jzimme14/Ares/Ares_v1/IchBinEineBiene1.jpg

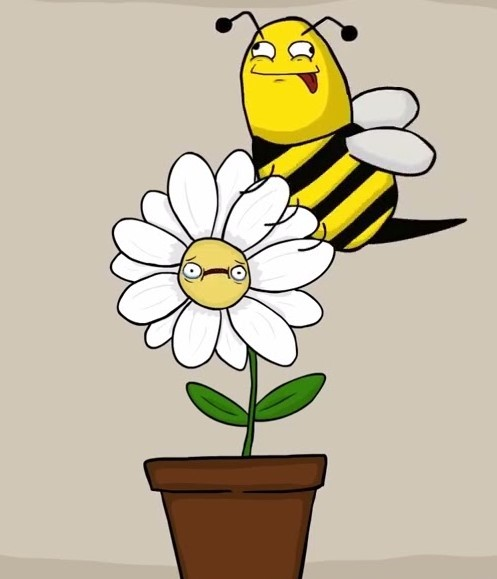
Ares_v1/IchBinEineBiene1.jpg
