jzimme14/Ares/README.md

# Ares
Flight Controller for autonomous drone.
