jzimme14/Ares/Ares_v1/arduino-nano-33-iot-pinout.png

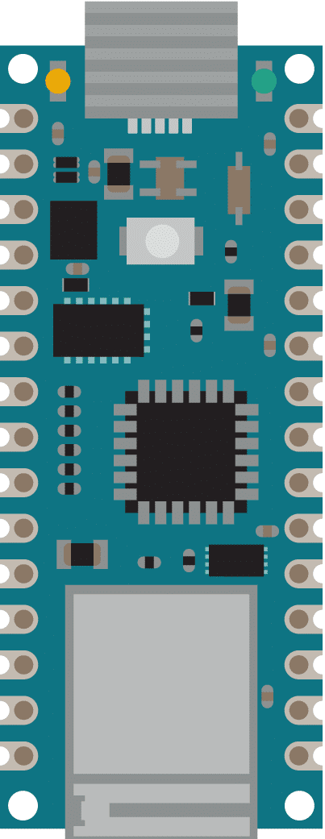
Ares_v1/arduino-nano-33-iot-pinout.png
