jzimme14/Ares/Ares_v1/retardedBee.png

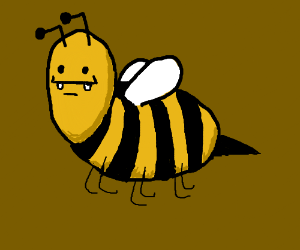
Ares_v1/retardedBee.png
