jzimme14/Ares/Ares_FC/parts/STM32F405RGT6/3D/STM32F405RGT6.stp

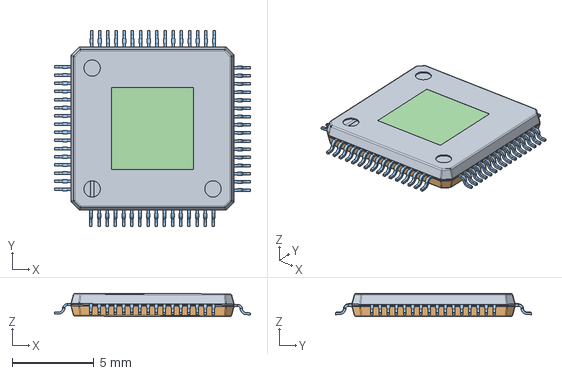
[picture p4: CAD file, 2024-05-15]
Ares_FC/parts/STM32F405RGT6/3D/STM32F405RGT6.stp
12.0 x 12.0 x 1.43 mm
