jzimme14/Ares/Ares_v1/parts/XT60-M.step

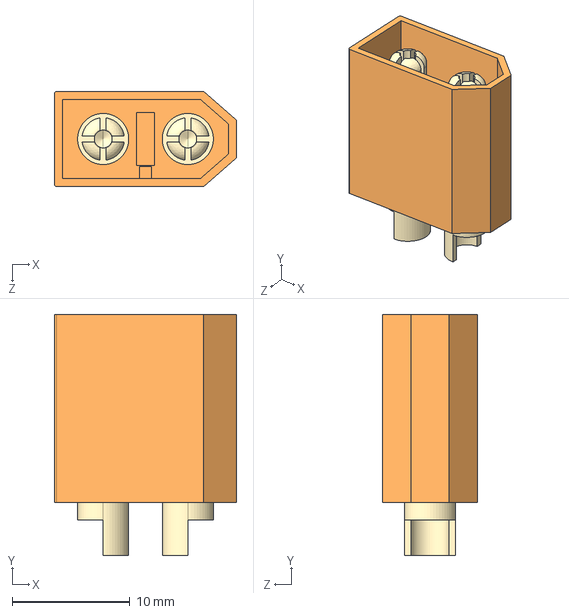
[picture p5: CAD file, 2025-03-02]
Ares_v1/parts/XT60-M.step
15.5 x 20.5 x 8.10 mm
