jzimme14/Ares/parts/1N4728A/3D/1N4728A.stp

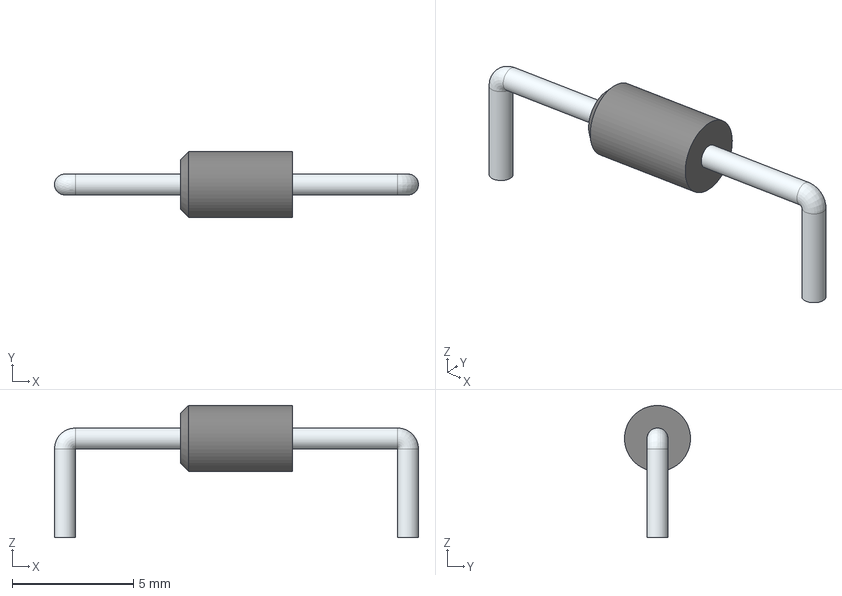
[picture p6: CAD file, 2025-03-02]
parts/1N4728A/3D/1N4728A.stp
15.0 x 2.72 x 5.44 mm
