jzimme14/Ares/parts/INA240A3EDRQ1/3D/INA240A3EDRQ1.stp

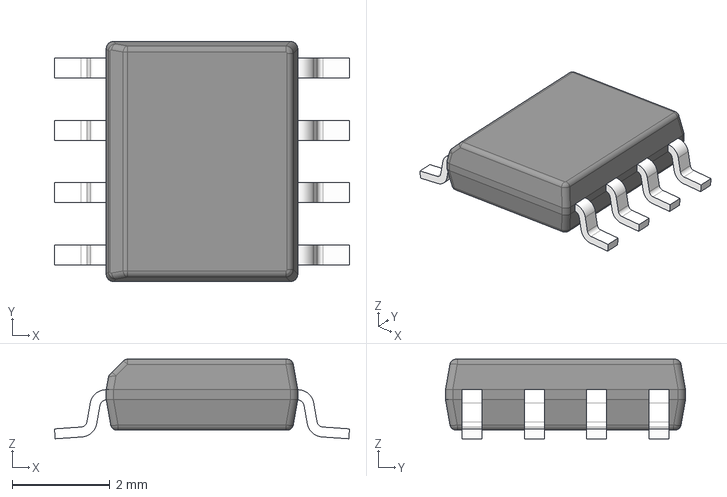
[picture p7: CAD file, 2025-03-02]
parts/INA240A3EDRQ1/3D/INA240A3EDRQ1.stp
6.02 x 4.90 x 1.63 mm
BODY-SO
LEAD-D0008A x 8
