jzimme14/Ares/parts/IR2101PBF/3D/IR2101PBF.stp

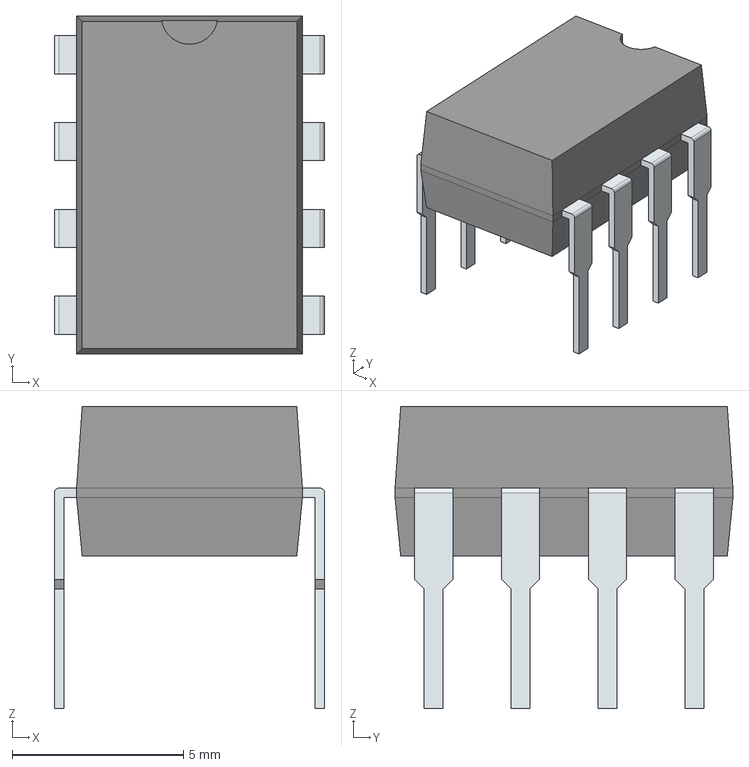
[picture p8: CAD file, 2025-03-02]
parts/IR2101PBF/3D/IR2101PBF.stp
7.90 x 9.88 x 8.83 mm
PinsArrayLR
