jzimme14/Ares/parts/IRLZ44NPBF/3D/IRLZ44NPBF.stp

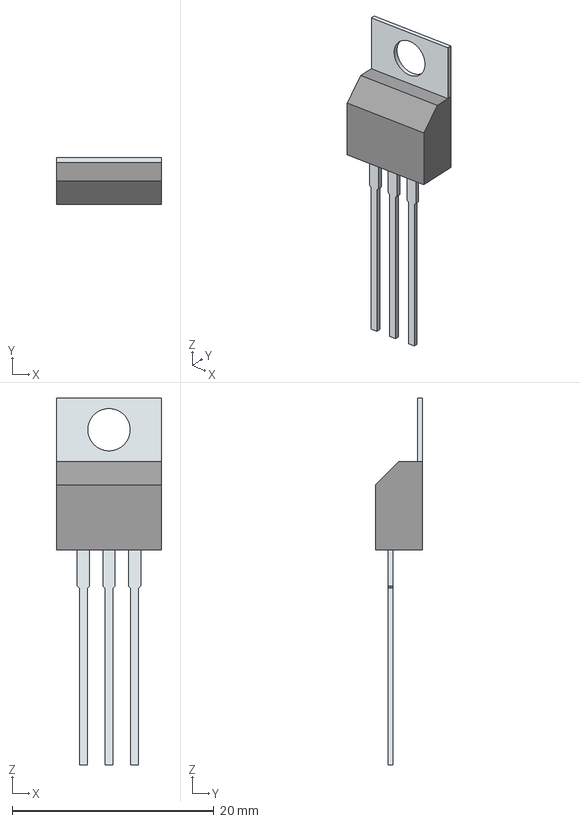
[picture p9: CAD file, 2025-03-02]
parts/IRLZ44NPBF/3D/IRLZ44NPBF.stp
10.4 x 4.69 x 36.4 mm
Tab
PinsArray
