jzimme14/Ares/parts/STM32F411RET6/STM32F411RET6/3D/STM32F411RET6.stp

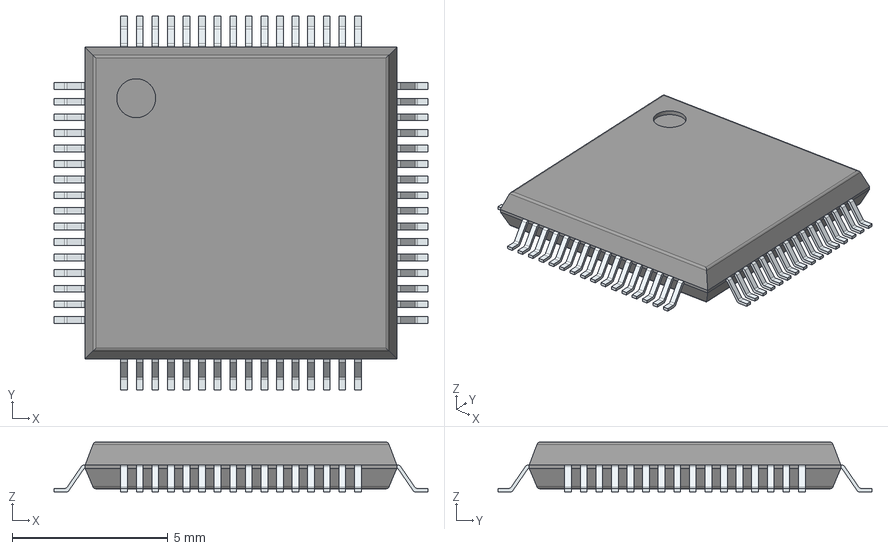
[picture p10: CAD file, 2025-03-02]
parts/STM32F411RET6/STM32F411RET6/3D/STM32F411RET6.stp
12.0 x 12.0 x 1.60 mm
PinsArrayLR
PinsArrayTB
