jzimme14/Ares/parts/STTH4L06/3D/STTH4L06.stp

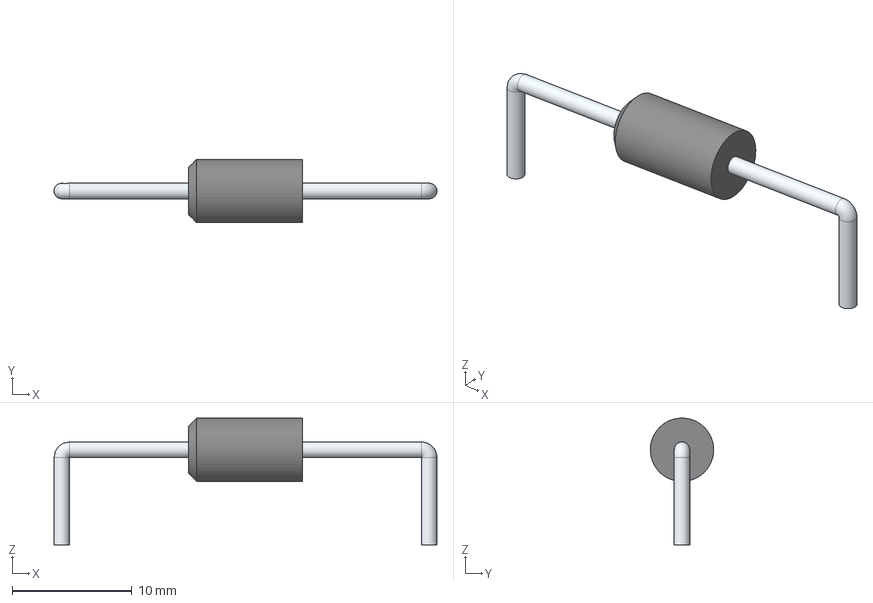
[picture p11: CAD file, 2025-03-02]
parts/STTH4L06/3D/STTH4L06.stp
32.0 x 5.30 x 10.6 mm
