jzimme14/Ares/Ares_v1/parts/B4B-XH-AM__LF__SN_.step

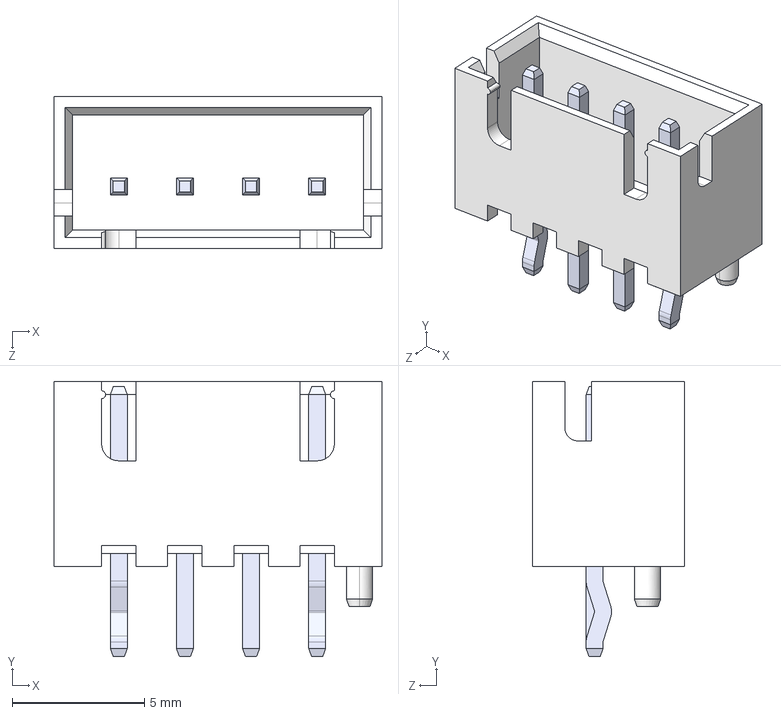
[picture p12: CAD file, 2025-03-02]
Ares_v1/parts/B4B-XH-AM__LF__SN_.step
12.4 x 10.4 x 5.75 mm
