jzimme14/Ares/Ares_v1/parts/M20-7821642/3D/M20-7821642.stp

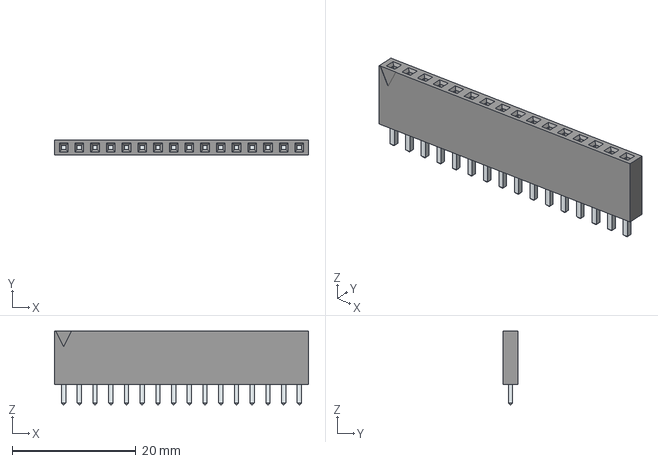
[picture p13: CAD file, 2025-03-02]
Ares_v1/parts/M20-7821642/3D/M20-7821642.stp
41.0 x 2.50 x 11.9 mm
LeadsArray
