jzimme14/Ares/parts/Wuerth_Quartz_25MHz/3D/830107871909.stp

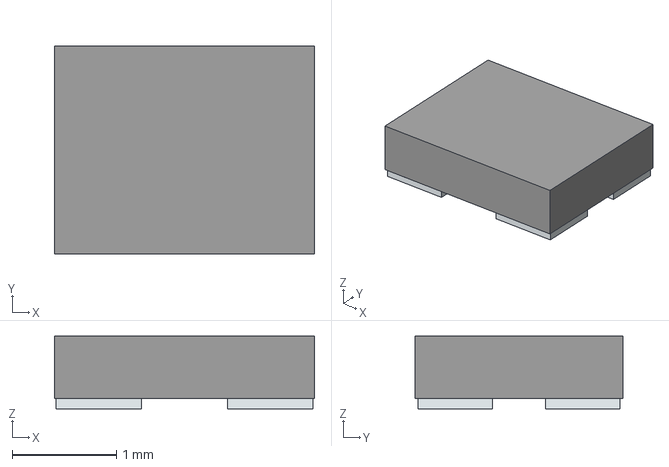
[picture p14: CAD file, 2025-03-02]
parts/Wuerth_Quartz_25MHz/3D/830107871909.stp
2.50 x 2.00 x 0.7 mm
Pins
