jzimme14/Ares/(list of files, cad)

Other CAD files:
Ares_FC/parts/MICRO-SD-CARD/Allegro/microsdcard.psm
Ares_FC/parts/MICRO-SD-CARD/DEHDL/micro_sd_card/chips/chips.prt
Ares_FC/parts/STM32F405RGT6/Allegro/qfp50p1200x1200x160-64n.psm
Ares_FC/parts/STM32F405RGT6/DEHDL/stm32f405rgt6/chips/chips.prt
Ares_FC/parts/STM32F405VGT6/Allegro/qfp50p1600x1600x160-100n.psm
Ares_FC/parts/STM32F405VGT6/DEHDL/stm32f405vgt6/chips/chips.prt
Ares_FC/parts/STM32H742VIT6/Allegro/qfp50p1600x1600x160-100n.psm
Ares_FC/parts/STM32H742VIT6/DEHDL/stm32h742vit6/chips/chips.prt
Ares_v1/parts/M20-7821642/Allegro/rhdr16w70p0x254_1x16_4104x250x865p.psm
Ares_v1/parts/M20-7821642/DEHDL/m20_7821642/chips/chips.prt
parts/1N4728A/Allegro/dioad1413w86l463d238.psm
parts/1N4728A/DEHDL/1n4728a/chips/chips.prt
parts/INA240A3EDRQ1/Allegro/soic127p600x175-8n.psm
parts/INA240A3EDRQ1/DEHDL/ina240a3edrq1/chips/chips.prt
parts/IR2101PBF/Allegro/dip762w56p254l988h533q8n.psm
parts/IR2101PBF/DEHDL/ir2101pbf/chips/chips.prt
parts/IRLZ44NPBF/Allegro/to254p469x1042x1967-3p.psm
parts/IRLZ44NPBF/DEHDL/irlz44npbf/chips/chips.prt
parts/STM32F411RET6/STM32F411RET6/Allegro/qfp50p1200x1200x160-64n.psm
parts/STM32F411RET6/STM32F411RET6/DEHDL/stm32f411ret6/chips/chips.prt
parts/STTH4L06/Allegro/dioad3070w130l950d530.psm
parts/STTH4L06/DEHDL/stth4l06/chips/chips.prt
parts/Wuerth_Quartz_25MHz/Allegro/830107871909.psm
parts/Wuerth_Quartz_25MHz/DEHDL/830107871909/chips/chips.prt
