jzimme14/Ares/(list of files, drawings)

Other design files:
Ares_v1/parts/M20-7821642/Altium/M20-7821642.SchLib
Ares_v1/parts/M20-7821642/Altium/RHDR16W70P0X254_1X16_4104X250X865P.PcbLib
parts/1N4728A/Altium/1N4728A.SchLib
parts/1N4728A/Altium/DIOAD1413W86L463D238.PcbLib
parts/INA240A3EDRQ1/Altium/INA240A3EDRQ1.SchLib
parts/INA240A3EDRQ1/Altium/SOIC127P600X175-8N.PcbLib
parts/IR2101PBF/Altium/DIP762W56P254L988H533Q8N.PcbLib
parts/IR2101PBF/Altium/IR2101PBF.SchLib
parts/IRLZ44NPBF/Altium/IRLZ44NPBF.SchLib
parts/IRLZ44NPBF/Altium/TO254P469X1042X1967-3P.PcbLib
parts/STM32F411RET6/STM32F411RET6/Altium/QFP50P1200X1200X160-64N.PcbLib
parts/STM32F411RET6/STM32F411RET6/Altium/STM32F411RET6.SchLib
parts/STTH4L06/Altium/DIOAD3070W130L950D530.PcbLib
parts/STTH4L06/Altium/STTH4L06.SchLib
parts/Wuerth_Quartz_25MHz/Altium/830107871909.PcbLib
parts/Wuerth_Quartz_25MHz/Altium/830107871909.SchLib
