jzimme14/Ares/Beestaeuber_v1/Beestaeuber_v1_project/Beestaeuber_v1_project.kicad_pcb

## KiCad design Beestaeuber_v1/Beestaeuber_v1_project/Beestaeuber_v1_project.kicad_pcb (2025-03-02)

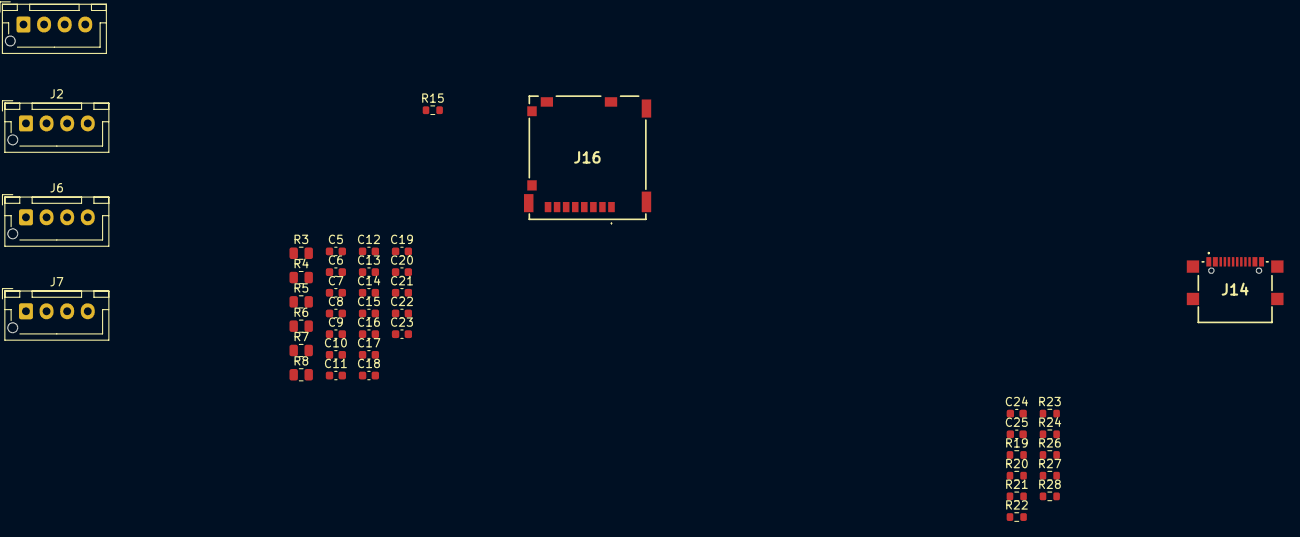
[picture p15: board Beestaeuber_v1_project.kicad_pcb from above]

Board: 2 copper layers, 43 parts (0 on the bottom side), 20 nets, no tracks yet.

Parts:
C5, C6, C7, C8, C10, C11, C12, C13, C14, C15, C20, C21, C24: 100n; C_0603_1608Metric
C9, C25: 10u; C_0603_1608Metric
C16, C18: 10n; C_0603_1608Metric
C17, C19: 1u; C_0603_1608Metric
C22, C23: 2u2; C_0603_1608Metric
J1: B4B-XH-AM__LF__SN_; JST_XH_B4B-XH-AM_1x04_P2.50mm_Vertical
J2: ELRS_Receiver; JST_XH_B4B-XH-AM_1x04_P2.50mm_Vertical
J6: CAM Connector; JST_XH_B4B-XH-AM_1x04_P2.50mm_Vertical
J7: VTX Output; JST_XH_B4B-XH-AM_1x04_P2.50mm_Vertical
J14: GSB1C41110SSHR
J16: MEM2090-00-145-00-A; MEM20900014500A
R3: 47k; R_0805_2012Metric
R4, R6, R8: 330k; R_0805_2012Metric
R5: 33k; R_0805_2012Metric
R7: 22k; R_0805_2012Metric
R15, R19, R20, R21, R22, R23, R24: 47k; R_0603_1608Metric
R26, R27: 10k; R_0603_1608Metric
R28: 100k; R_0603_1608Metric

Connections:
+3.3VA: C16.1, C17.1, C18.1, C19.1
+3V3: C9.1, C10.1, C11.1, C12.1, C13.1, C14.1, C15.1, C25.1, J16.4 (VDD), R15.1, R19.1, R20.1, R21.1, R22.1, R23.1, R24.1, R26.1, R27.1
+5V: C8.1, J2.3
/D14/A0: C7.1, R7.2, R8.1
/D15/A1: C6.1, R5.2, R6.1
/D20/A6: C5.1, R3.2, R4.1
/Lipo_Cell_1: J1.2, R7.1
/Lipo_Cell_1_2: J1.3, R5.1
/Lipo_Cell_1_2_3: J1.4, R3.1
GND: C5.2, C6.2, C7.2, J1.1, J16.6 (VSS), J16.10 (GROUND_1), J16.11 (GROUND_2), J16.12 (GROUND_3), J16.13 (GROUND_4), J16.14 (GROUND_5), J16.15 (GROUND_6), R4.2, R6.2, R8.2
SDMMC1_CMD: J16.3 (CMD), R24.2
SDMMC1_D0: J16.7 (DAT0), R20.2
SDMMC1_D1: J16.8 (DAT1), R15.2, R19.2
SDMMC1_D2: J16.1 (DAT2), R22.2
SDMMC1_D3: J16.2 (CD/DAT3), R23.2
USB_DN_1: J14.A7 (DN1), J14.B7 (DN2)
USB_DP_1: J14.A6 (DP1), J14.B6 (DP2)
USB_GND_1: C8.2, C9.2, C10.2, C11.2, C12.2, C13.2, C14.2, C15.2, C16.2, C17.2, C18.2, C19.2, C20.2, C21.1, C22.2, C23.2, C24.2, C25.2, J2.4, J14.A1 (GND_1), J14.A12 (GND_2), J14.MP1, J14.MP2, J14.MP3, J14.MP4, R28.2
VBUS_1: C20.1, J14.A4 (VBUS_1), J14.A9 (VBUS_2)
VCAP1: C22.1, C23.1
