jzimme14/Ares/Ares_v1/Ares_v1_BaseBoard/Ares_v1_BaseBoard.kicad_pcb

## KiCad design Ares_v1/Ares_v1_BaseBoard/Ares_v1_BaseBoard.kicad_pcb (2025-03-02)

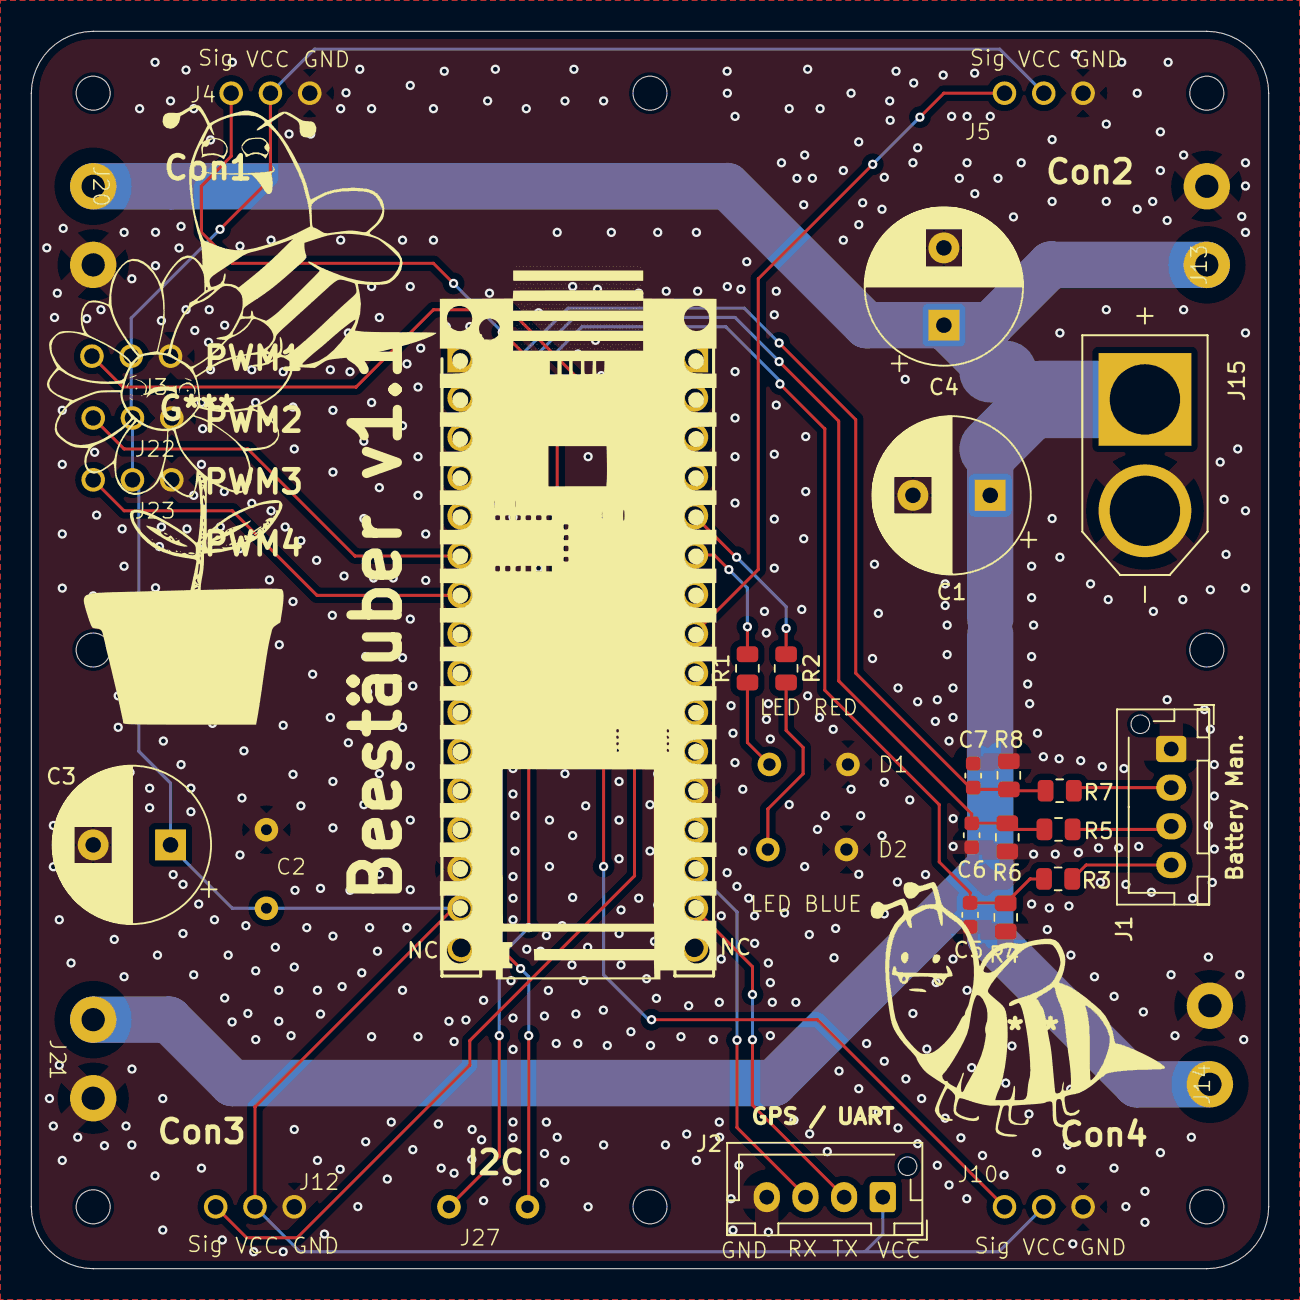
[picture p16: board Ares_v1_BaseBoard.kicad_pcb from above]

Board: 2 copper layers, 80.0 x 80.0 mm, 33 parts (0 on the bottom side), 24 nets.

Parts:
C1, C3, C4: 1000u; CP_Radial_D10.0mm_P5.00mm
C2: 100n; cap_tht_ceramic
C5, C6, C7: 100n; C_0603_1608Metric
D1: LED/Rot; PowerKlemme
D2: LED/Blau; PowerKlemme
J1, J2: B4B-XH-AM__LF__SN_; JST_XH_B4B-XH-AM_1x04_P2.50mm_Vertical
J3: PWM1/D10; Stiftleiste3Pin
J4: PWM Connector 1; Stiftleiste3Pin
J5: PWM Connector 2; Stiftleiste3Pin
J10: PWM Connector 4; Stiftleiste3Pin
J12: PWM Connector 3; Stiftleiste3Pin
J13: Motor Power Connector 2; PowerKlemme
J14: Motor Power Connector 4; PowerKlemme
J15: XT60-M; AMASS_XT60-M
J20: Motor Power Connector 1; PowerKlemme
J21: Motor Power Connector 3; PowerKlemme
J22: PWM2/D16; Stiftleiste3Pin
J23: PWM3/D17; Stiftleiste3Pin
J27: I2C_Conn; PowerKlemme
R1: 220; R_0805_2012Metric
R2: 0; R_0805_2012Metric
R3: 47k; R_0805_2012Metric
R4, R6, R8: 330k; R_0805_2012Metric
R5: 33k; R_0805_2012Metric
R7: 22k; R_0805_2012Metric
U1: ABX00027; ArduinoNano33IOT_Stiftleiste

Connections:
+5V: C2.1, C3.1, J2.1, J3.2, J4.2, J5.2, J10.2, J12.2, J22.2, J23.2, U1.15 (VIN)
+12V: C1.1, C4.1, J13.1, J14.1, J15.P (POS), J20.1, J21.1
/D4/PWM: J4.1, U1.22 (D4)
/D5/PWM: J5.1, U1.23 (D5/PWM)
/D6/PWM: J12.1, U1.24 (D6/PWM)
/D7/LED1: R1.1, U1.25 (D7)
/D8/LED2: R2.1, U1.26 (D8)
/D9/PWM: J10.1, U1.27 (D9/PWM)
/D10/PWM: J3.1, U1.28 (D10/PWM)
/D14/A0: C7.1, R7.2, R8.1, U1.4 (A0/DAC0)
/D15/A1: C6.1, R5.2, R6.1, U1.5 (A1)
/D16/PWM: J22.1, U1.6 (A2)
/D17/PWM: J23.1, U1.7 (A3)
/D18/SDA: J27.1, U1.8 (A4/SDA)
/D19/SCL: J27.2, U1.9 (A5/SCL)
/D20/A6: C5.1, R3.2, R4.1, U1.10 (A6)
/Lipo_Cell_1: J1.2, R7.1
/Lipo_Cell_1_2: J1.3, R5.1
/Lipo_Cell_1_2_3: J1.4, R3.1
/UART_RX: J2.3, U1.17 (RX)
/UART_TX: J2.2, U1.16 (TX)
GND: C1.2, C2.2, C3.2, C4.2, C5.2, C6.2, C7.2, D1.1 (K), D2.1 (K), J1.1, J2.4, J3.3, J4.3, J5.3, J10.3, J12.3, J13.2, J14.2, J15.N (NEG), J20.2, J21.2, J22.3, J23.3, R4.2, R6.2, R8.2, U1.14 (GND)
unnamed: D1.2 (A), R1.2
unnamed: D2.2 (A), R2.2
