jzimme14/Ares/(commit log)

2024-05-15 printfile added
    [Drone_3D_printerfile.3mf]
2024-05-15 added open source 3d-printing drone design as prototype. especially for FC testing
    [1+own+plate.stl, 2+spacer.stl, 3+Bottom+plate.stl, 4+cam+plate+1.stl, 6+cam+plate+2+.stl, Drone_3D_printerfile.3mf]
2024-05-17 pid controller in python implementation
2024-05-19 added low pass filter implementation and tools
2024-05-21 implemented low pass filter using backward euler to discretise calculated differential equation
